mvdw1/muxdemux/README.md

# muxdemux
Open source USB3.0 multiplexer/demultiplexer with serial, IO control, button control inputs
