mvdw1/muxdemux/hw/design/stackup.png

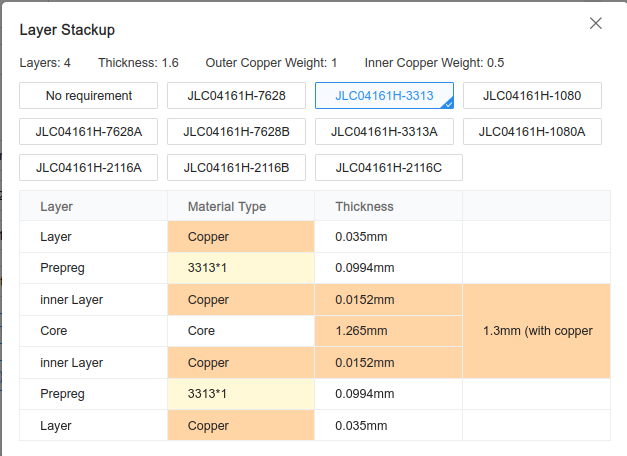
hw/design/stackup.png
