mvdw1/muxdemux/hw/design/SCH_usbmuxdemux_v0.1.pdf

## LED

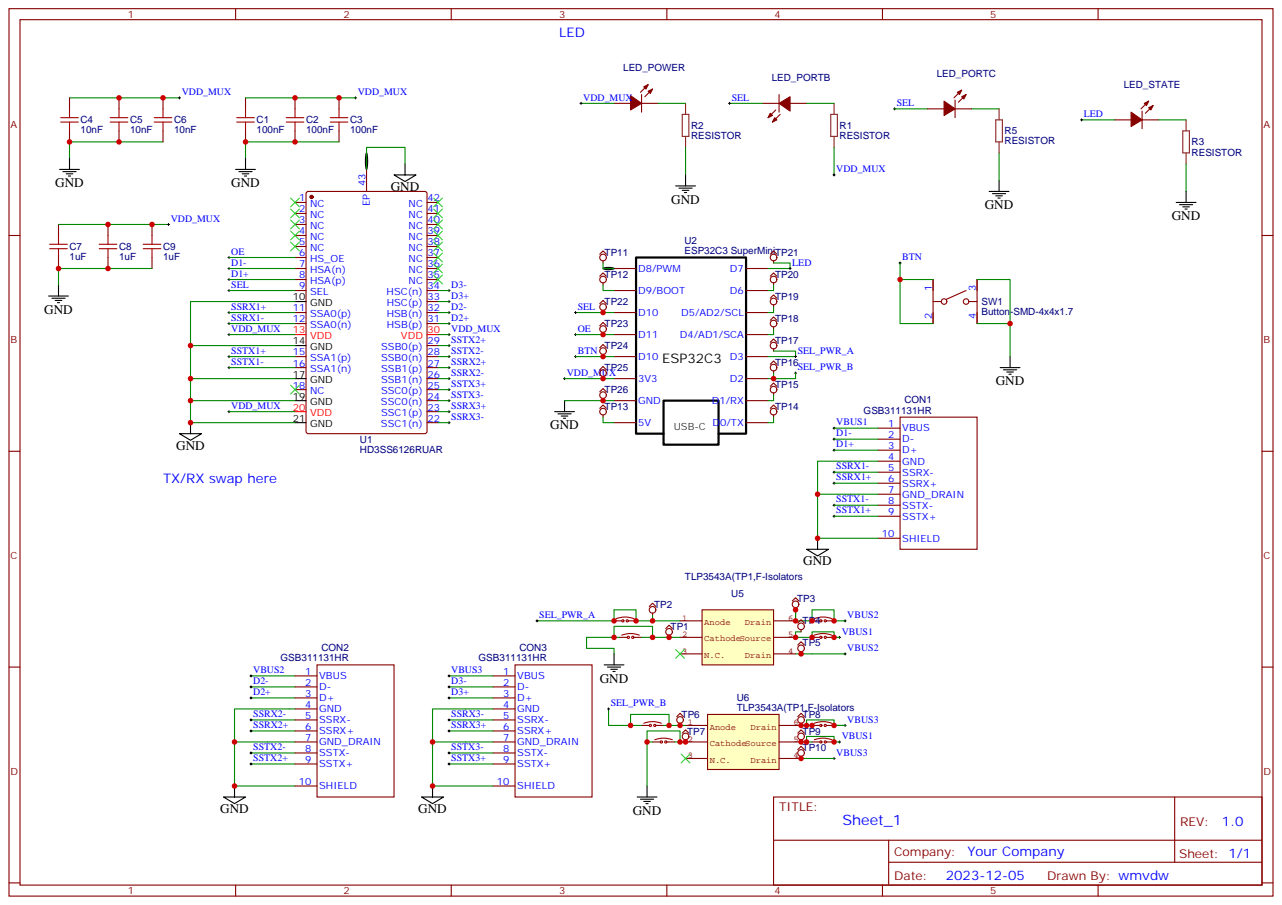
[picture p6: page 1]

TX/RX swap here
