mvdw1/muxdemux/hw/design/PCB_PCB_usbmuxdemux_bottom_v0.1.pdf

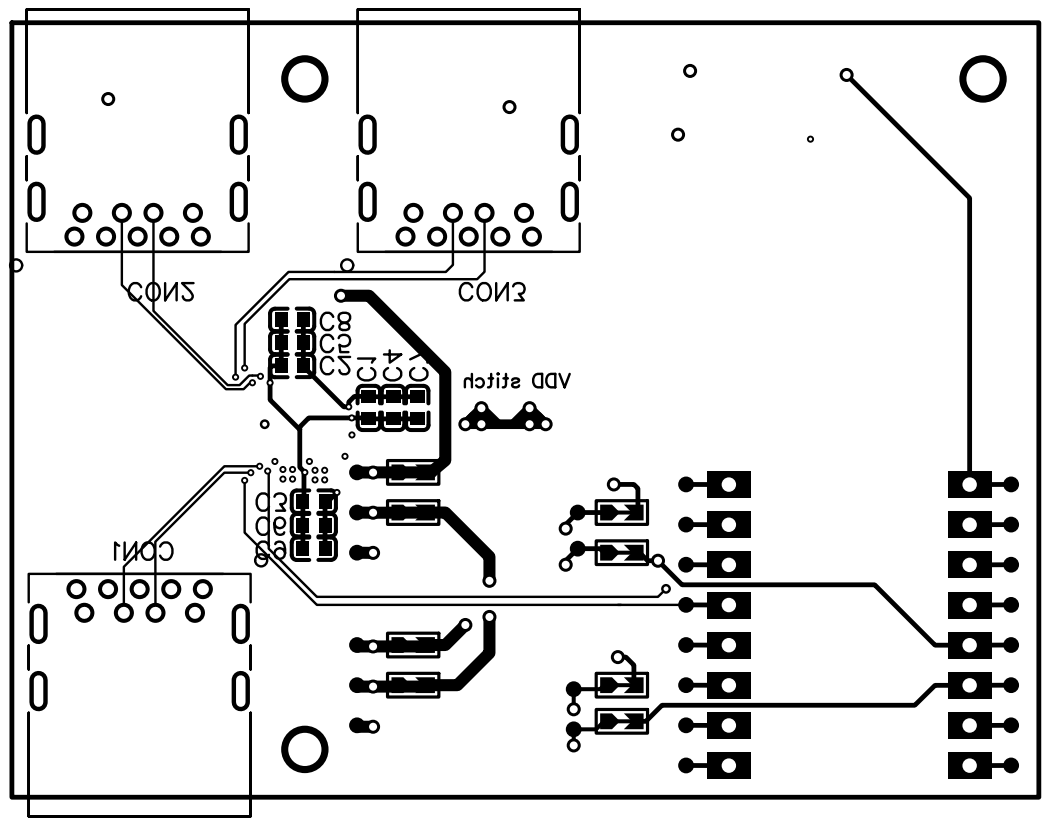
[picture p7: page 1]
