mvdw1/muxdemux/hw/design/PCB_PCB_usbmuxdemux_top_v0.1.pdf

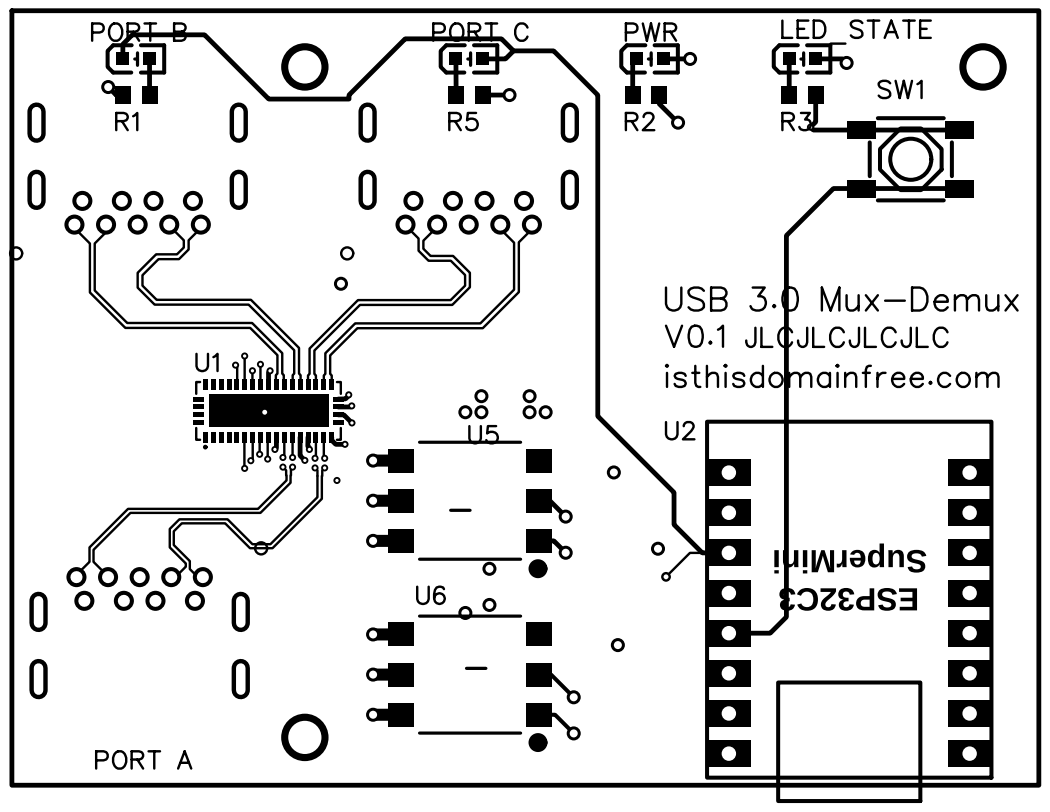
[picture p8: page 1]
