mvdw1/muxdemux/(list of files, drawings)

Other design files:
hw/design/PCB_PCB_usbmuxdemux_v0.1.json
hw/design/SCH_usbmuxdemux_v0.1.json
